Melabela/MatchGame-Arduino/_weekly_reports/02 Course Project Progress 1st Week Report.pdf

## Week 12 - Project Progress Report

CIS-033, Spring 2024

Melissa Li
Apr 27, 2024

## Table of Contents

## Timeline & Current Status

Week of | Done? | Planned Actions
April 22, 2024 | x | • Project Timeline Plan (this)
| x | • Assemble components
| x | • Determine Arduino Pin Assignments for all components
| x | • Do Unit Tests, verify individual components / blocks
| x | • Prepare schematic with all connections
April 29, 2024 | | • Breadboard full circuit, with all components
| | • Merge unit-test codes, verify components in single programs
| | • Design & document Game Logic
May 6, 2024 | | • Build structure to assemble all components suitable for game
| | • Mount RGB LED onto Servo-controlled part, and align fixed color LED in semi-circle around former
| | • Add score & game time
| | • Add simple sounds for game
| | • Test game mechanics
May 13, 2024 | | • Last minute changes (if any)
| | • Final polish

## Status of Parts

Components
- (Mostly using parts from Elegoo kit)
- ADDED to Project, since last week's report: (these also in Elegoo kit)
- Passive Buzzer: for basic sounds
- Push button: for user confirm input
- Purchased & received: LCD with I2C backpack
- (Save I/Os over parallel LCD, I/Os used by other components)

## Accomplishments This Week

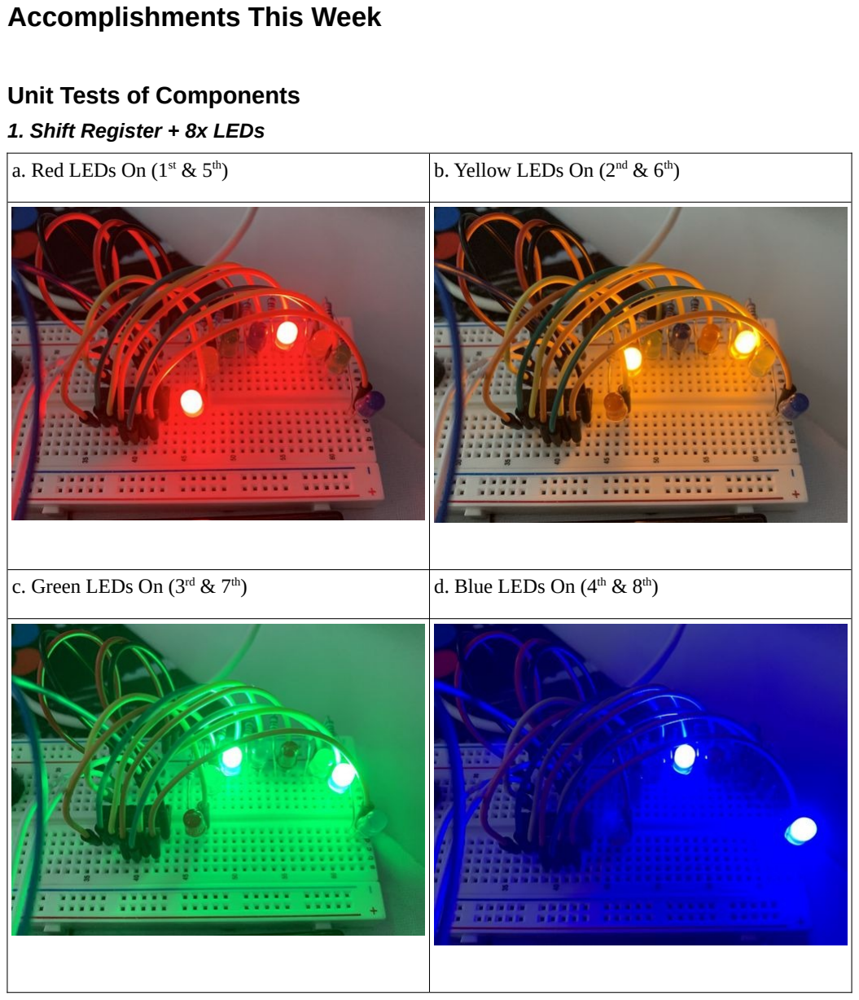
[picture p16: page 3]

Unit Tests of Components

### 1. Shift Register + 8x LEDs

a. Red LEDs On (1st & 5th) | b. Yellow LEDs On (2nd & 6th)
c. Green LEDs On (3rd & 7th) | d. Blue LEDs On (4th & 8th)

### 2. LCD with I2C backpack

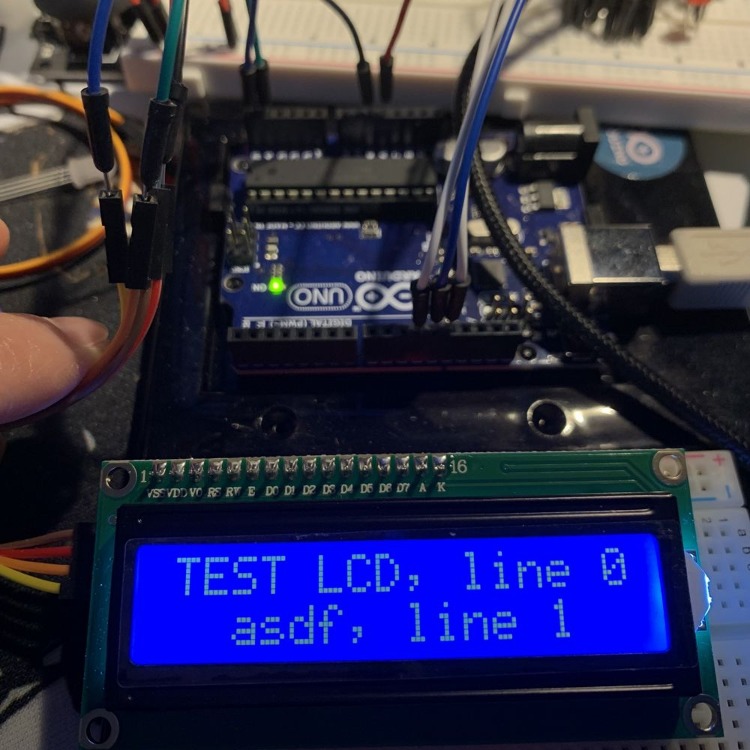
[picture p17: figure]
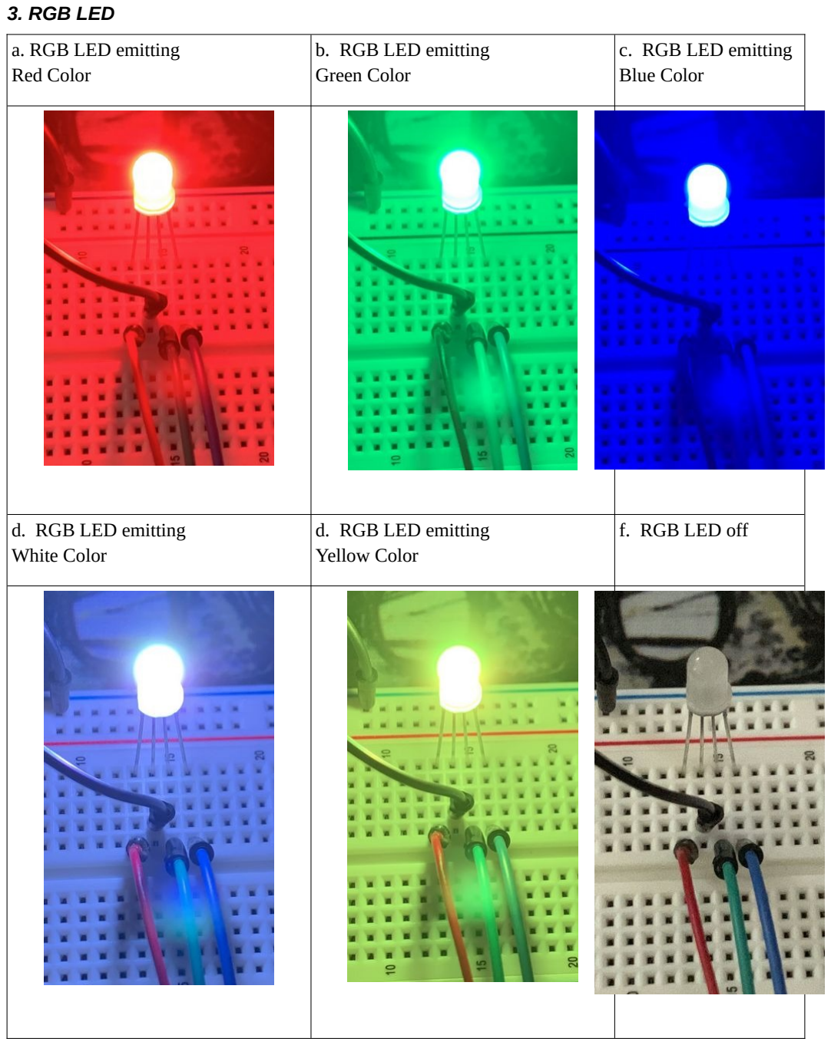
[picture p18: page 5]

### 3. RGB LED

a. RGB LED emitting
Red Color
b. RGB LED emitting
Green Color
c. RGB LED emitting
Blue Color
d. RGB LED emitting
White Color
d. RGB LED emitting
Yellow Color
f. RGB LED off

### 4. Passive Buzzer

(Use "Tuner" app on Smartphone, to "show" sound frequency being emitted by buzzer)

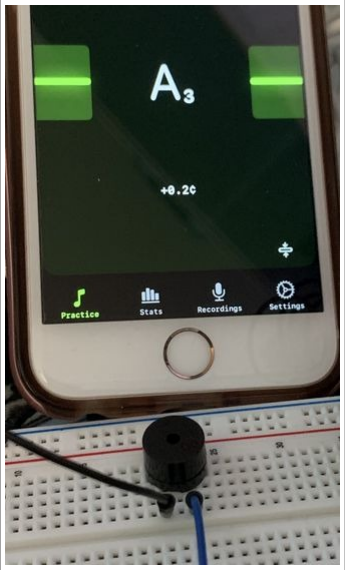
[picture p19: figure]

Play 3 notes, from A-major chord: A, C#, E.

a. Tone played at A3
(220 Hz)

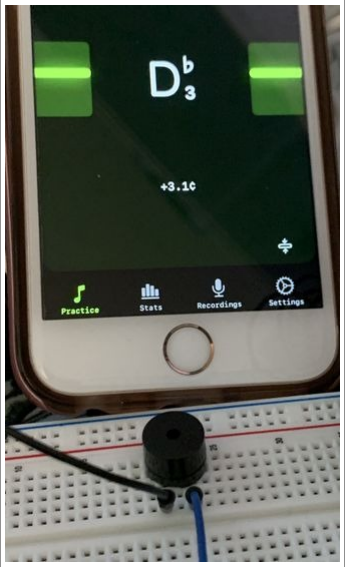
[picture p20: figure]

b. Tone at C#3
(139 Hz; shown as Db3)

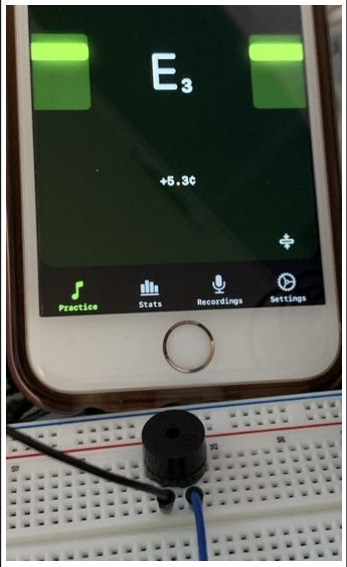
[picture p21: figure]

b. Tone at E3
(165 Hz)

### 5. NOT Unit Tested

These components NOT unit-tested, because we have used them in previously in this course.
- Joystick Input: implemented in Week 5 Lab
- Servo Motor: implemented in Week 6 Lab
- Push button Input: implemented in Week 8 Lab, with Interrupts

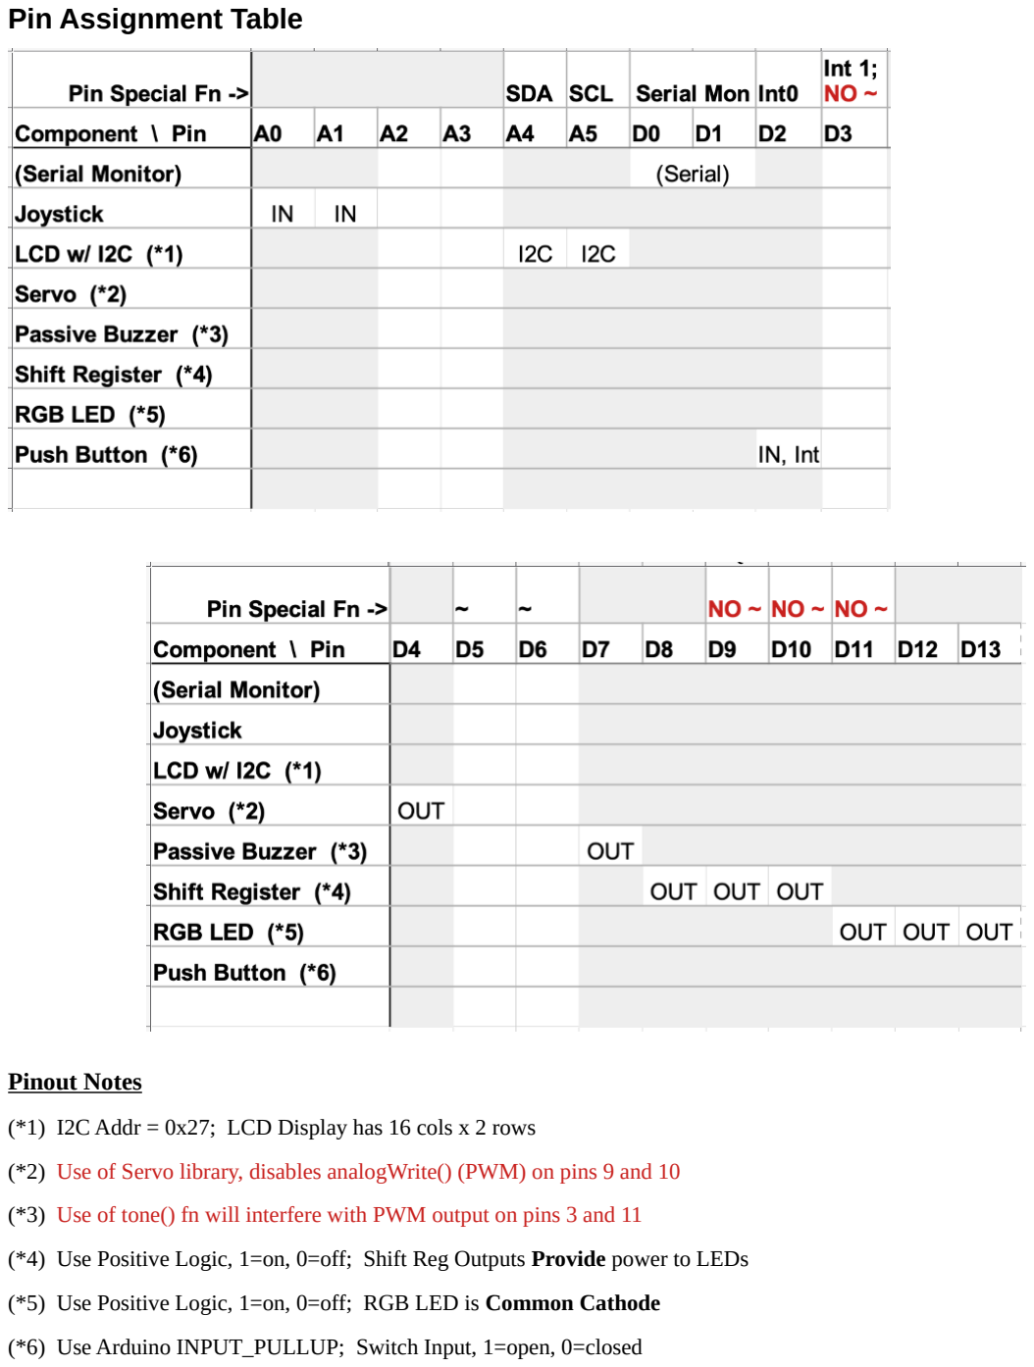
[picture p22: page 7]

Pin Assignment Table

Pinout Notes

(*1) I2C Addr = 0x27; LCD Display has 16 cols x 2 rows

(*2) Use of Servo library, disables analogWrite() (PWM) on pins 9 and 10

(*3) Use of tone() fn will interfere with PWM output on pins 3 and 11

(*4) Use Positive Logic, 1=on, 0=off; Shift Reg Outputs Provide power to LEDs

(*5) Use Positive Logic, 1=on, 0=off; RGB LED is Common Cathode

(*6) Use Arduino INPUT_PULLUP; Switch Input, 1=open, 0=closed

Circuit Schematic
(Schematic drawn in KiCad)

### 1. Arduino plus Small Components

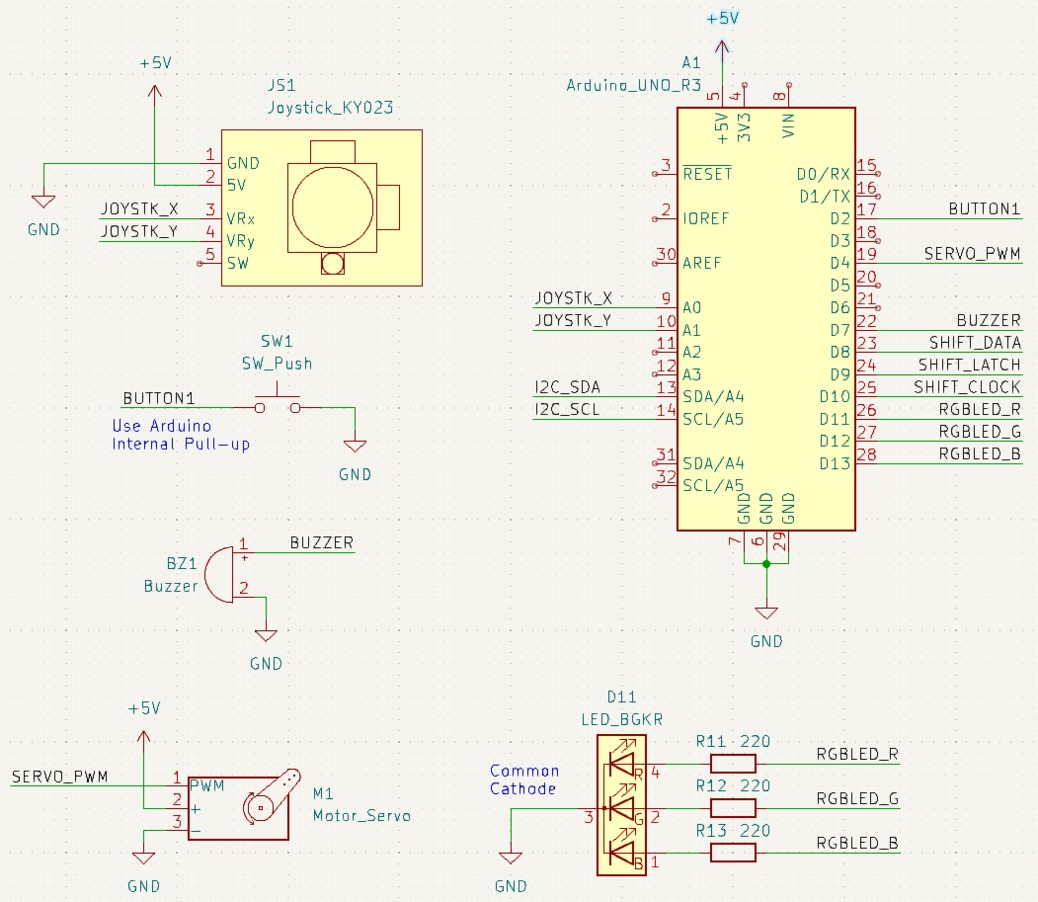
[picture p23: figure]
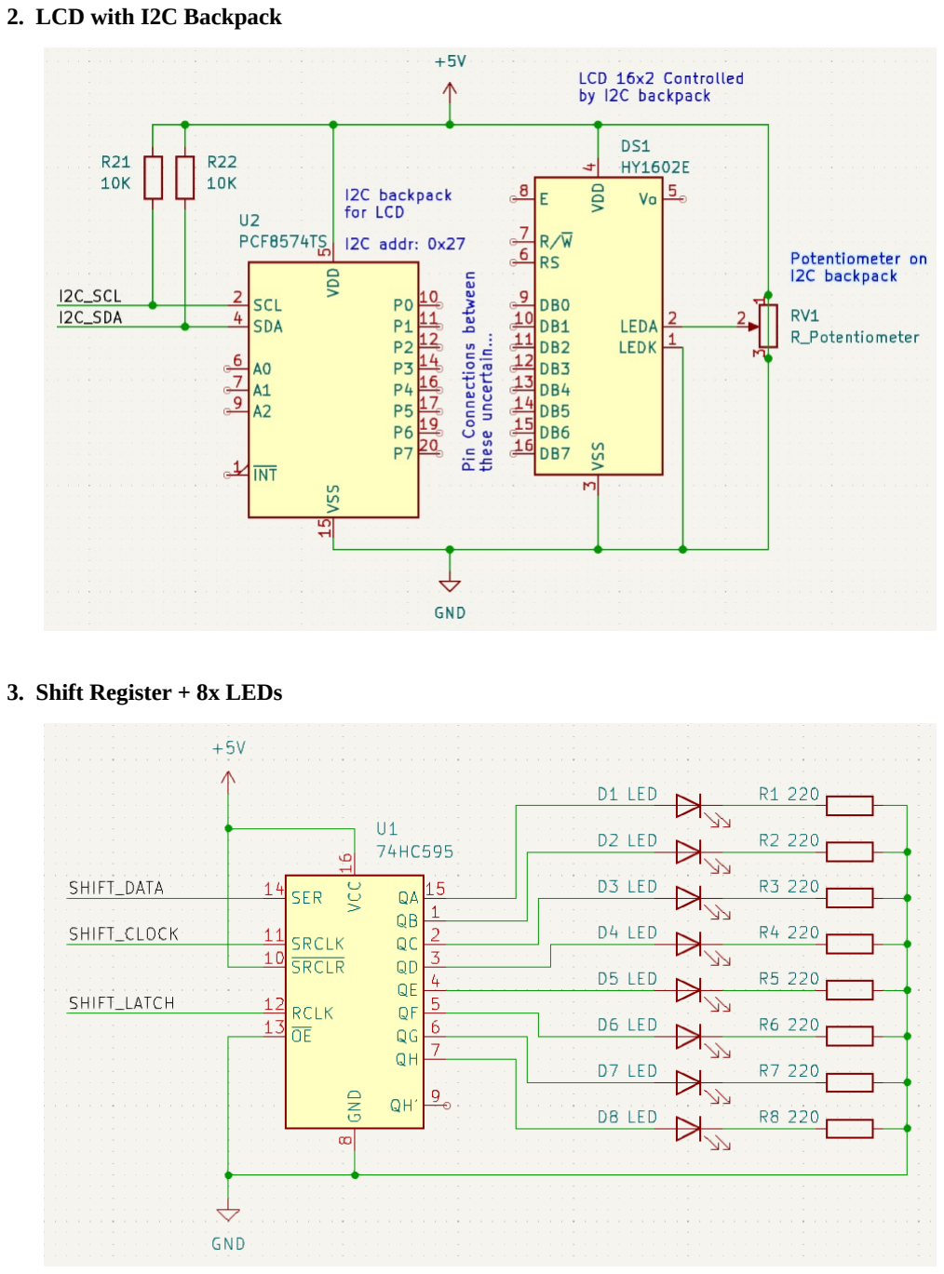
[picture p24: page 9]

### 2. LCD with I2C Backpack

### 3. Shift Register + 8x LEDs
