Melabela/MatchGame-Arduino/_design_docs/04a OnShape Sketch w Fixed LEDs.png

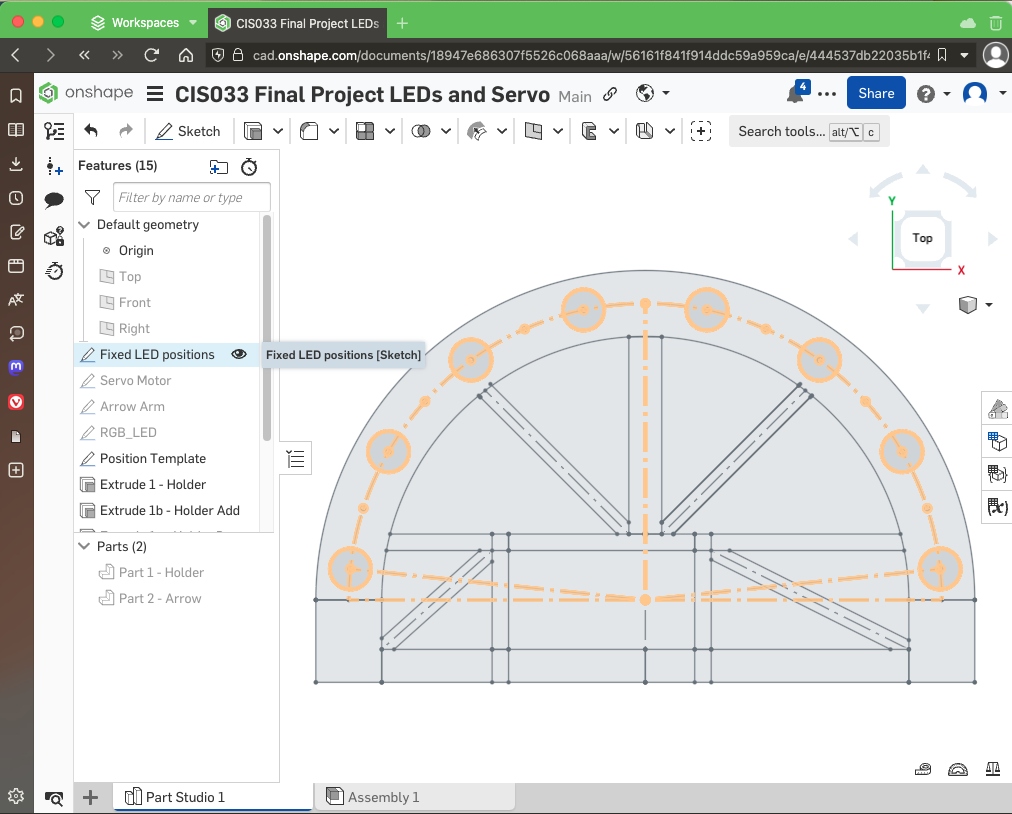
_design_docs/04a OnShape Sketch w Fixed LEDs.png
