Melabela/MatchGame-Arduino/_design_docs/05a OnShape 3D CAD Part Front View.png

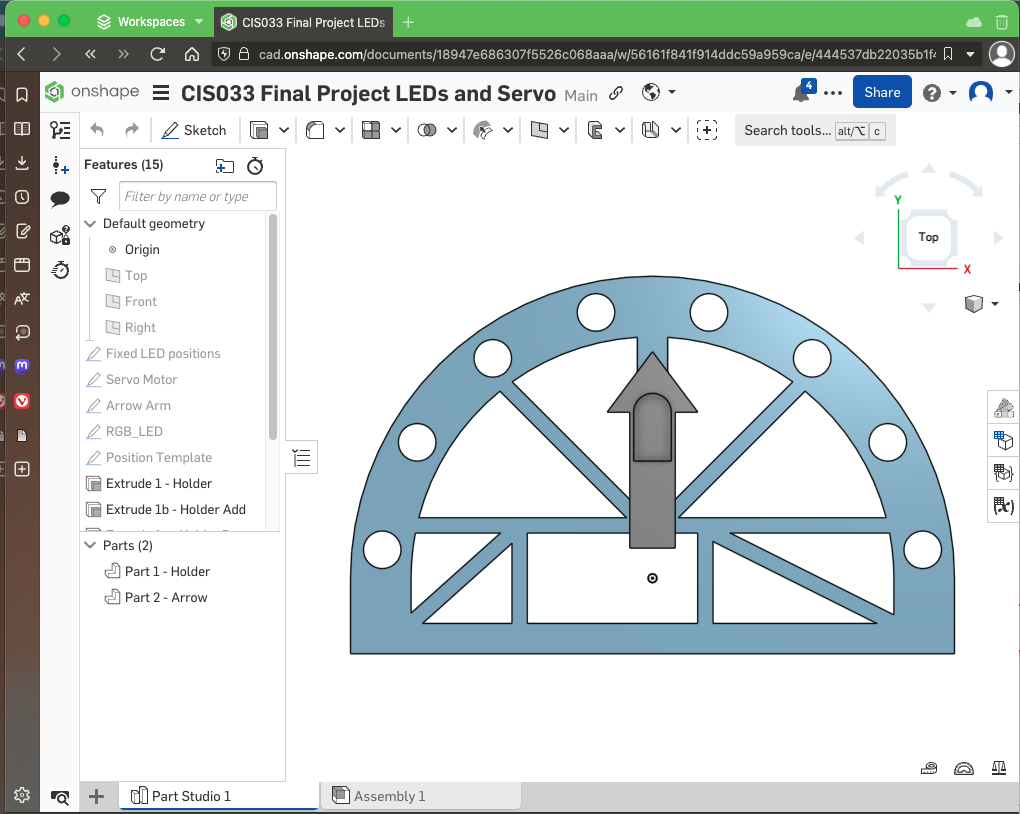
_design_docs/05a OnShape 3D CAD Part Front View.png
