Melabela/MatchGame-Arduino/_design_docs/05b OnShape 3D CAD Part Angled View.png

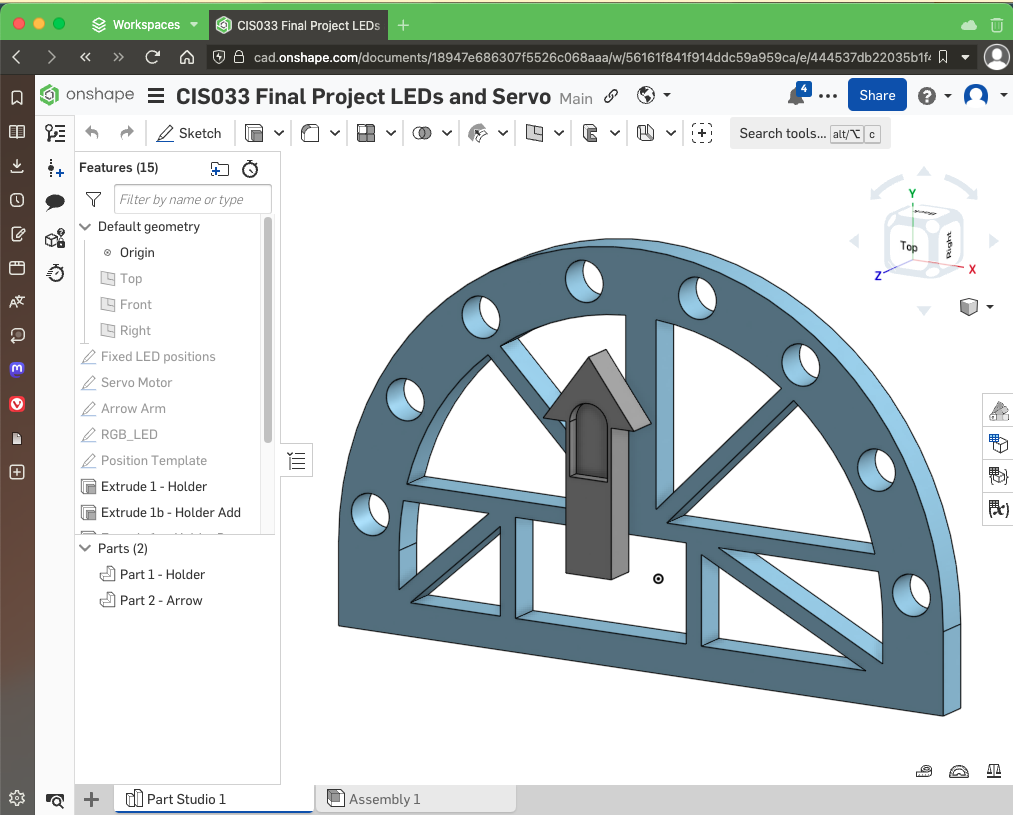
_design_docs/05b OnShape 3D CAD Part Angled View.png
