Melabela/MatchGame-Arduino/_design_docs/06a Logic Flowchart pg1.png

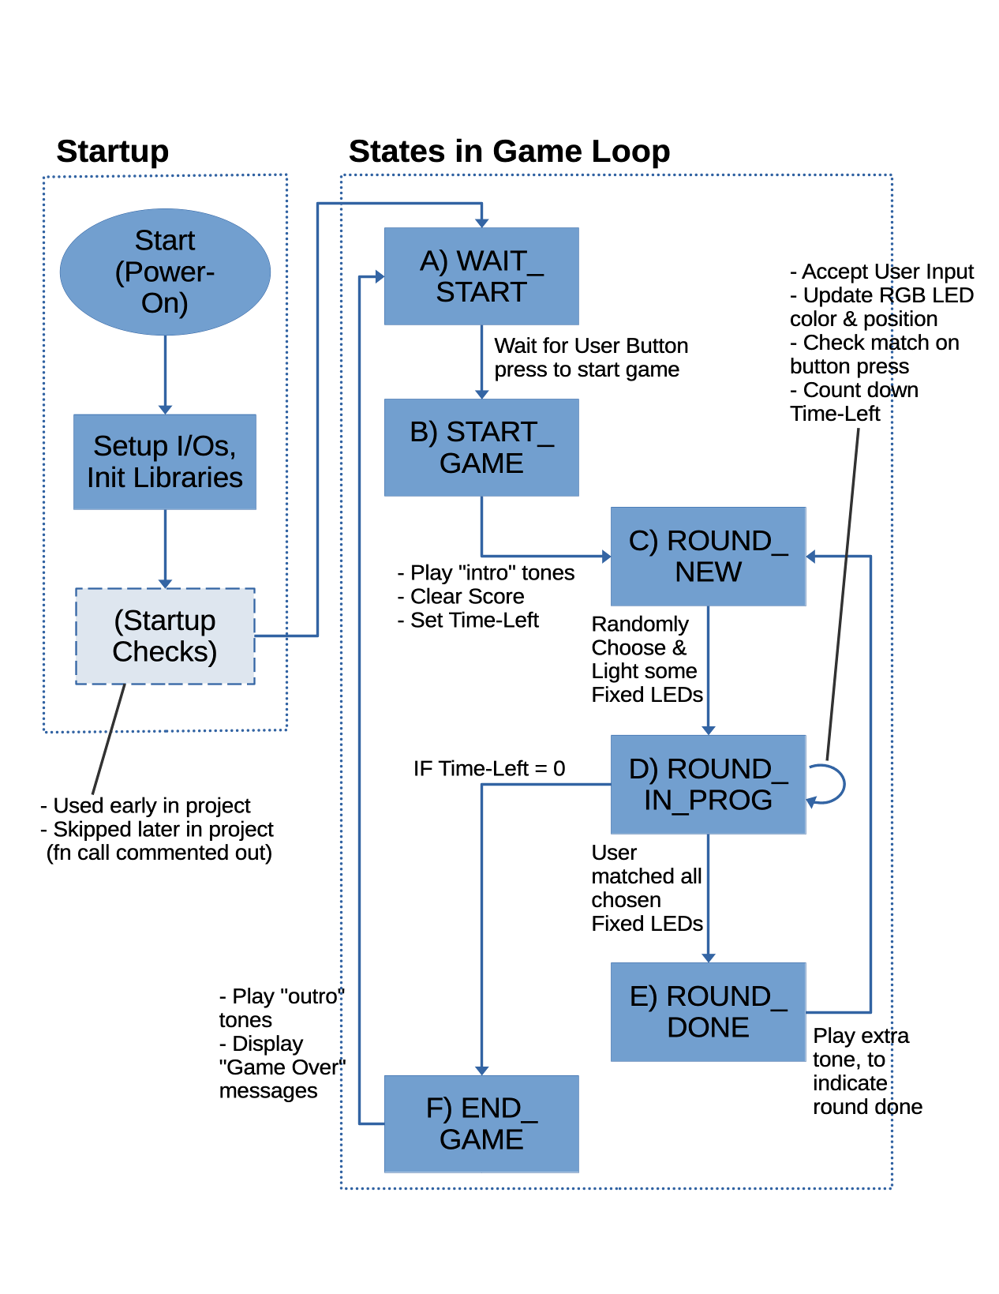
_design_docs/06a Logic Flowchart pg1.png
