Melabela/MatchGame-Arduino/_design_docs/06b Logic Flowchart pg2.png

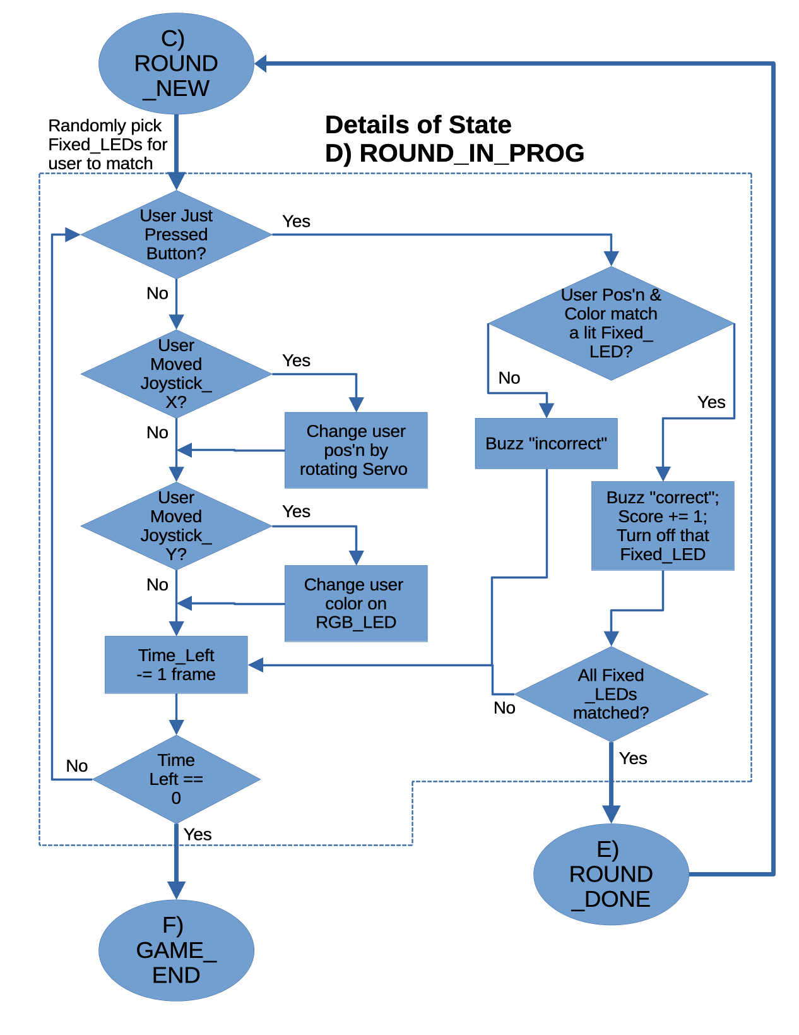
_design_docs/06b Logic Flowchart pg2.png
