Melabela/MatchGame-Arduino/_design_docs/07b Project Assembled - Breadboard Detail.jpg

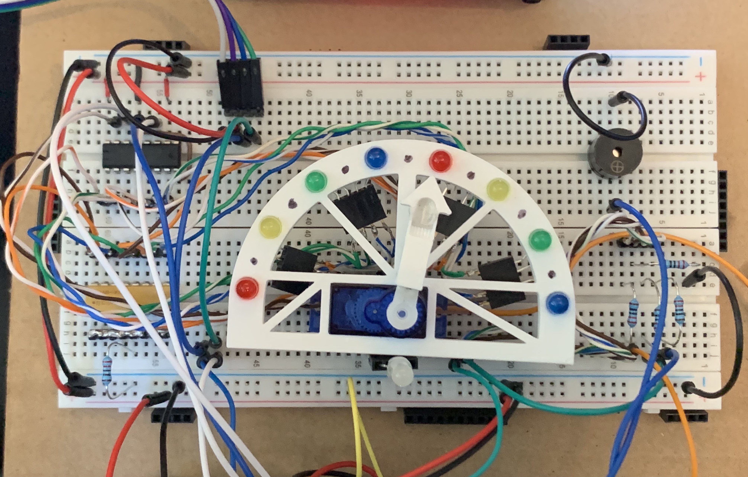
_design_docs/07b Project Assembled - Breadboard Detail.jpg
