Melabela/MatchGame-Arduino/_design_docs/07c Project Assembled - Breadboard Components.png

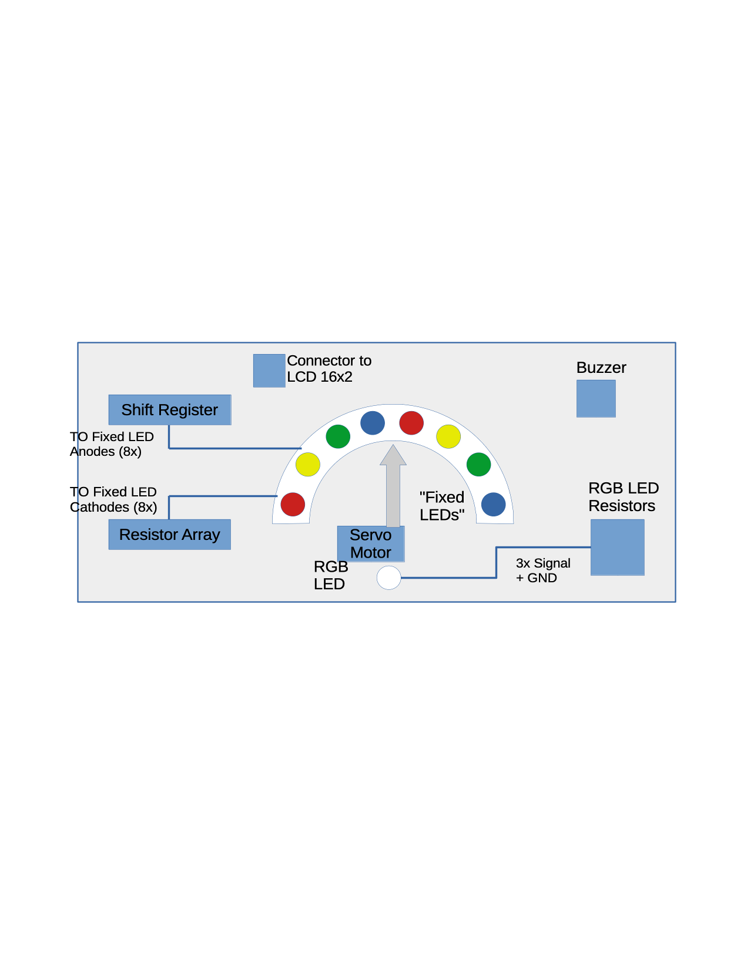
_design_docs/07c Project Assembled - Breadboard Components.png
