Melabela/MatchGame-Arduino/_design_docs/03 Project Schematic.pdf

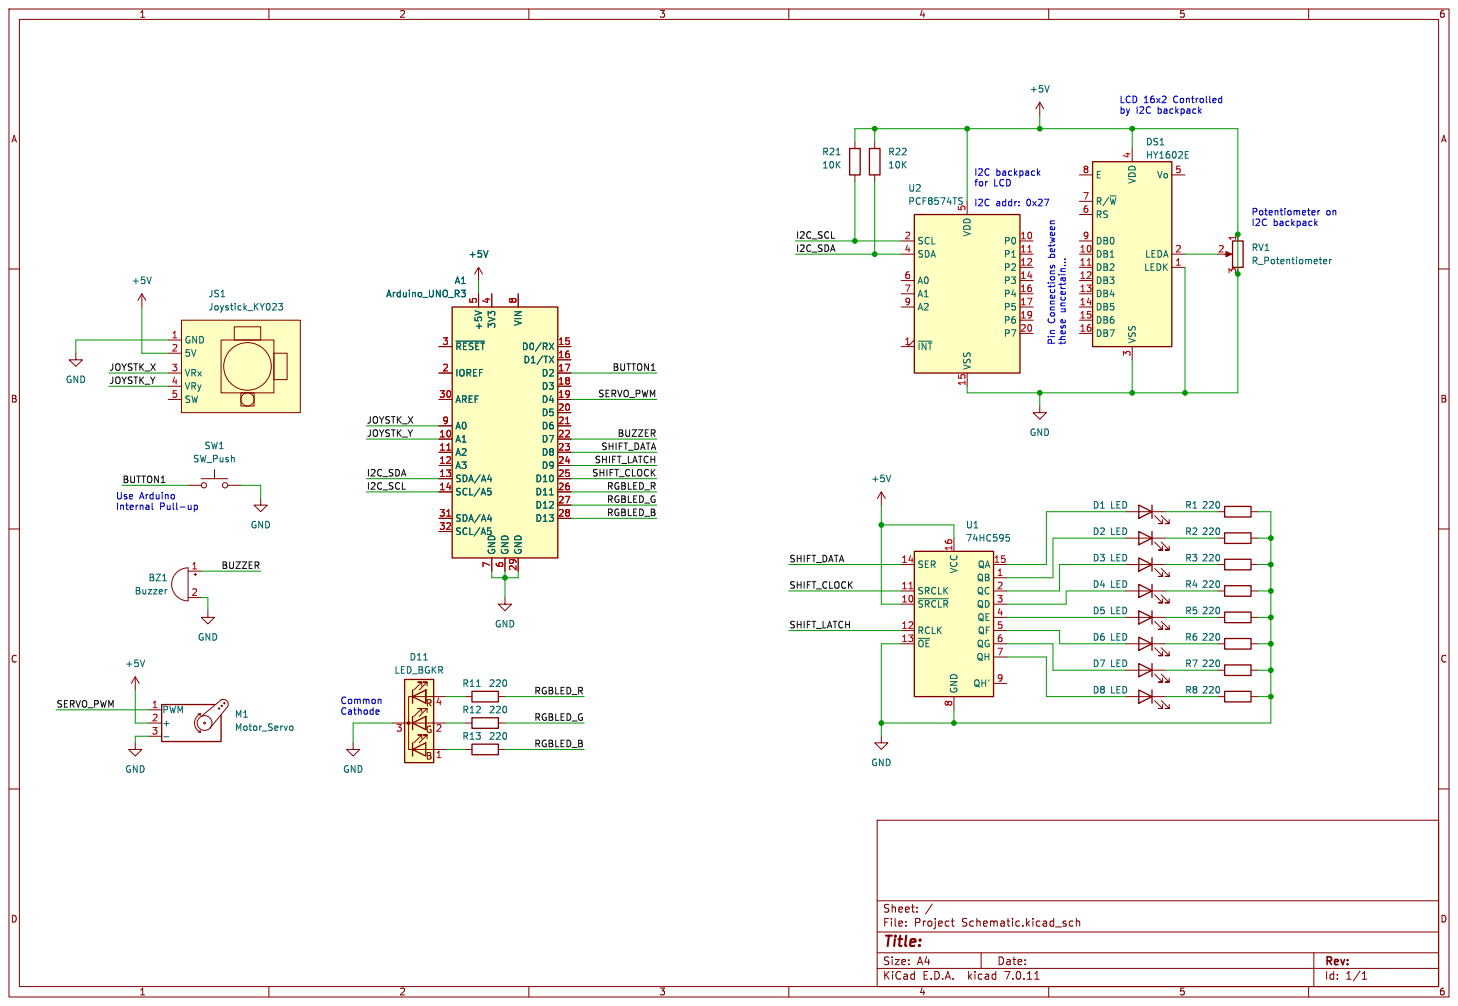
[picture p33: page 1]
