Melabela/MatchGame-Arduino/(commit log)

2024-08-07 Servo: rotate opposite dir (reverse angles), and increase angle separation
    [project_code.ino]
2024-08-07 Read button & joystick Inputs, temp test in loop() fn
2024-08-07 Add Game States empty framework, and frames movement in loop() -> process_frame()
    - Add GAME_ST_* enums for Game States
    - Add process_frame() fn, which calls individual fns per the game state
    - Add loop() fn, which waits until time for next frame, and call process_frame()
    - Remove input fns from loop() for now. Will be added back later.
    Note: could NOT use <TimerOne.h>, since Servo library also uses Timer1 hardware
    hence the method in loop() fn to step time
2024-08-07 Add WAIT_START game state logic; and change game_state_*() fns to return next state
    - (First entry) Display msg on LCD, that user needs to press button to start
    - (Subsequent) Check button input, and wait until user presses button
    Also change game_state_*() fns to return the next_state, so process_frame() can update that
2024-08-07 Disable button_read()'s DEBUG_PRINT; it clutters Serial Monitor output, as it is printed every frame
2024-08-07 Add START_GAME game state, do some game initialization
    - move Servo to middle, set RGBLED off
    - set time frames_remain, and reset score
    [project_code.ino]
2024-08-07 Add strings for GAME_ST_* enums, so Serial.print()s at top of process_frame() show name, instead of enum_id
2024-08-07 Count down frames in process_frame(), and update time/score to display in game_state_round_in_prog()
2024-08-07 Fix LCD display flicker in previous commit
    Due to lcd.clear() and update text in Every Frame of display_update_time_score()
    Change so:
    - NO lcd.clear() call, and
    - only update digits parts of time_remain & score
    - also show 10ths of second part of time_remain, to "tick" more frequently
    [project_code.ino]
2024-08-07 Add reading button/joystick inputs in ROUND_IN_PROG game state, to manipulate RGBLED color & position (latter via Servo)
    - Add new fn handle_inputs_round() to do above-mentioned work
    - Add empty fn check_for_match() on button pressed, to fill in later
2024-08-07 Improve handle_input_round(), to apply inputs more slowly
    Previous commit applied inputs every frame, and moved thru Servo positions
    / rotated thru RGBLED colors, way too fast.
    Apply a cooldown so we only apply the joystick input once every N frames.
    Now can see discrete steps in both Servo positions, and RGBLED colors.
    [project_code.ino]
2024-08-07 Disable joystick_read_x_y()'s DEBUG_PRINT; it clutters Serial Monitor output, as it is printed every frame
2024-08-07 Add list of 'fixed_leds_colors', and rename a few variables to make their value clearer
    - Add 'fixed_leds_colors', with Fixed LED colors as arranged on board.
    Will need this later, for matching with user position & color.
    - Rename 'game_user_color' to 'game_user_color_idx', as value
    is idx lookup into rgbled_user_colors[]
    - Rename 'game_round_fixed_LEDs' to 'game_fixed_leds_mask_on',
    make explicit value is used as bitmask, bits for which Fixed LEDs are ON
    [project_code.ino]
2024-08-07 Add matching code, when user presses button during round
    - Add check_for_match() fn: do 3 checks, all need to be true, to consider a match
    - Add update_on_match() fn: turn off the matched Fixed LED, and award point
    - In handle_inputs_round(), check 'game_fixed_leds_mask_on',
    if all Fixed LEDs off, then can move to ROUND_DONE game state.
    [project_code.ino]
2024-08-07 Refactor game_state_round_in_prog() and children fns
    - move outer levels of former handle_inputs_round() fn
    (read & call fns for button/joystick), out to game_state_round_in_prog()
    - rename handle_inputs_round() as handle_joystick_inputs_in_round(),
    as remaining code now does only the latter
2024-08-07 Add basic ROUND_DONE game state code, in game_state_round_done() fn
    When user clears a batch of Fixed LEDs, goto ROUND_START state,
    so that a new set of Fixed LEDs are selected for user to match.
    [project_code.ino]
2024-08-07 Move 'millis_at_last_frame' as a static variable in loop() fn, as only used there
2024-08-07 Refactor game_state_round_new(): choosing random Fixed LEDs into new fn, and move set LCD fixed text
    - pull out choosing random Fixed LEDs, into new fn pick_random_fixed_leds()
    - move "set LCD fixed text" ("Time Left:" and "Score:" labels)
    up to game_state_start_game(), b/c we always show this during game
    [project_code.ino]
2024-08-07 WIP: tune servo rotation angles, to compensate for inaccuracies
    Testing against 3D designed & printed frame, with exact 12 degrees rotation per point
2024-08-07 game_state_end_game(): on first entry, also turn off Fixed & RGB LEDs
    [project_code.ino]
2024-08-07 Add buzzer tones on okay/failed matches, in game_state_round_in_prog() when user presses button
    - in 'bHaveMatch' case, play a high tone to indicate success
    - add else case to above, and play a low tone to indicate failure
    [project_code.ino]
2024-08-07 BUGFIX: in game_state_round_in_prog() - when user holds button, it incorrectly keeps checking match
    When user button press is held across frames, should not do continued check.
    e.g. holding button at correct match, made a buzzer makes high->low sound,
    which is misleading.
    FIX: change button check logic - copy from game_state_wait_start() fn,
    to check only on button press edge (press_now && !press_last_frame)
    [project_code.ino]
2024-08-07 Play a few notes in game_state_round_done(), to tell users there another round, more LEDs to match
    Since ROUND_DONE will take some time playing these notes, change
    decrementing 'game_frames_remain' to only in ROUND_IN_PROG state.
